himanshusangwan250-hash/esp32-wifi-quadcopter/120_final_nocam.stl

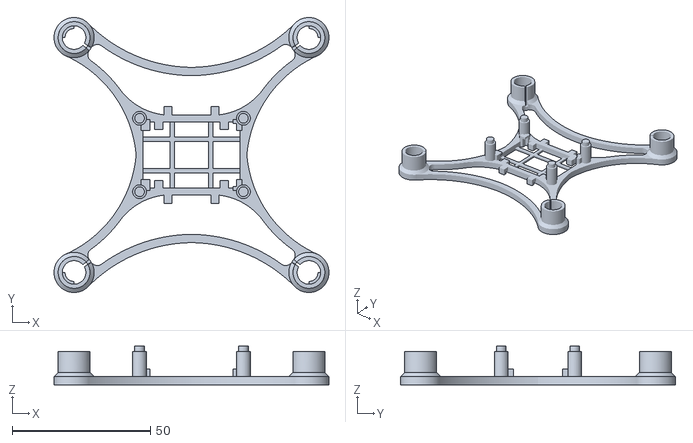
[picture p1: CAD file, 2026-10-31]
120_final_nocam.stl
99.3 x 99.3 x 14.0
