himanshusangwan250-hash/esp32-wifi-quadcopter/base.stl

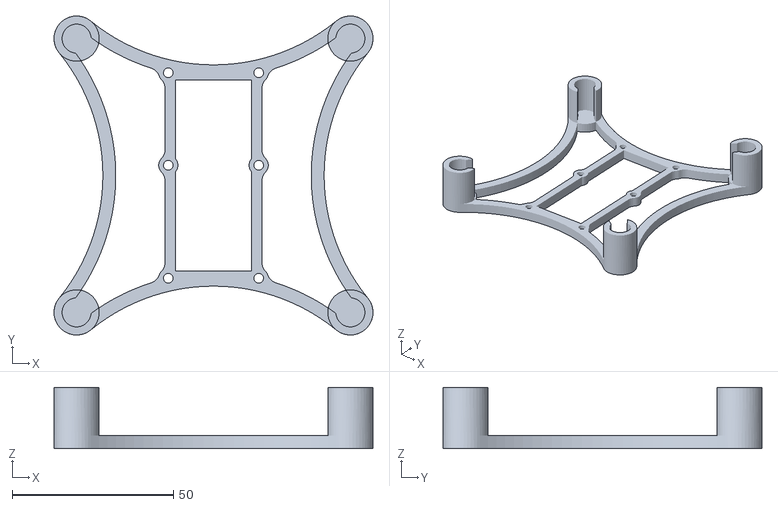
[picture p2: CAD file, 2026-10-31]
base.stl
98.9 x 98.9 x 19.0
